HAONMIK1/park-assist/docs/hardware.md

# 하드웨어

## 구성

**독립된 유닛 두 대**를 앞뒤 범퍼에 각각 물린다
([ADR 0004](decisions/0004-two-device-split.md)).

| 유닛 | 광고 이름 | 장착 위치 | 센서 |
| --- | --- | --- | --- |
| 후방 | `PARK-01` | 뒤 번호판 / 트렁크 리드 | 4 |
| 전방 | `PARK-02` | 앞 번호판 | 4 |

두 유닛은 **회로도 핀맵 펌웨어가 완전히 같다.** 펌웨어의 `ZONE_IS_REAR` 매크로만 바꿔서
굽는다. 한쪽이 꺼져도 다른 쪽은 그대로 동작한다.

## 부품 목록 (2대 기준)

| 구분 | 부품 | 수량 | 비고 |
| --- | --- | --- | --- |
| MCU | ESP32 DevKitC 30핀 | 2 | 유닛당 1 |
| 거리 센서 | JSN-SR04T 방수 초음파 모듈 | 8 | 유닛당 4 |
| 경보 | 액티브 부저 HW-508 | 2 | 유닛당 1, 자체 발진 |
| 전원 | (미정) | 2 | 아래 "전원" 참조 |
| 기구 | 집게형 마운트 | 2 | 번호판에 물림 |

## 핀맵 (유닛 공통)

| 채널 | Trig (출력) | Echo (입력) |
| --- | --- | --- |
| CH1 | GPIO 13 | GPIO 34 |
| CH2 | GPIO 25 | GPIO 35 |
| CH3 | GPIO 26 | GPIO 36 (VP) |
| CH4 | GPIO 27 | GPIO 39 (VN) |
| 부저 | GPIO 4 | — |

물리 배치는 **차량을 위에서 봤을 때 CH1이 왼쪽 끝, CH4가 오른쪽 끝**이다.
앞뒤 유닛 모두 운전자 기준 좌우를 따른다. BLE 패킷의 `d1`~`d4`가 이 순서에 대응한다
([`ble-protocol.md`](ble-protocol.md) 참조).

### GPIO 34/35/36/39 주의

- **입력 전용 핀이다.** 출력으로 설정할 수 없다.
- **내부 풀업/풀다운이 없다.** `INPUT_PULLUP`을 쓸 수 없으므로, 플로팅이 문제가 되면
  외부 저항을 단다.
- 36(VP)/39(VN)은 ADC1과 공유된다. 이 프로젝트에서는 디지털 입력으로만 쓴다.

### GPIO 4 (부저)

부저는 **ESP32에 직결**한다. BLE·앱과 무관하게 울려야 하는 안전 경로이므로 중간에
어떤 통신 요소도 두지 않는다 ([ADR 0001](decisions/0001-buzzer-direct-drive.md)).

HW-508은 액티브 부저라 `digitalWrite(HIGH/LOW)`로 켜고 끈다. `tone()` / LEDC PWM으로
주파수를 만들 필요가 없다. **음색을 바꿀 수 없으므로 경보 강도는 울림 간격으로만
표현한다** ([`ble-protocol.md`](ble-protocol.md) 6절).

부저 소비 전류가 GPIO 허용치(권장 12mA, 절대 최대 40mA)를 넘으면 NPN 트랜지스터나
MOSFET으로 구동하고, 코일성 부하일 경우 역기전력 다이오드를 단다.

## JSN-SR04T 특성과 그 결과

| 항목 | 값 |
| --- | --- |
| 동작 전압 | 5V |
| 측정 범위 | 약 25cm ~ 450cm |
| **사각지대(blind zone)** | **약 25cm 이내** |
| 빔 각도 | 약 45~75° (넓음) |

### ⚠️ 사각지대와 "위험" 기준의 충돌

기본 위험 기준은 **30cm**인데 센서 사각지대가 **약 25cm**다. 25cm보다 가까워지면
측정이 실패해 `0xFF`가 올라오고, 이는 프로토콜상 "측정 실패"와 구분되지 않는다.

**가장 위험한 순간에 값이 사라진다**는 뜻이므로, 펌웨어와 앱 양쪽에서 이렇게 처리한다.

- 직전까지 거리가 가까웠는데 `0xFF`로 바뀌면, 멀어진 것이 아니라 **사각지대에 진입한
  것으로 간주**하고 2초간 최고 단계 경보를 유지한다.
- 앱은 이때 숫자 대신 **"매우 가까움"** 을 크게 띄운다. 화면이 비면 안 된다.
- 멀리서 측정이 안 되는 경우(미연결 센서 등)와는 구분한다.

JSN-SR04T V3.0 등 일부 버전은 저항 값을 바꾸거나 모드를 바꾸면 최소 거리가 개선된다.
사용하는 보드 리비전을 확인할 것.

### ⚠️ 주행 중 감지 한계

주행 모드의 급접근 경보([ADR 0003](decisions/0003-app-alarm-and-drive-mode.md))는
이 센서의 물리적 한계에 묶여 있다. 측정 한계 약 250cm, 갱신 10Hz다.

| 상대속도 | 250cm 통과 시간 | 프레임 수 |
| --- | --- | --- |
| 10 km/h (2.8 m/s) | 0.90초 | 약 9 |
| 30 km/h (8.3 m/s) | 0.30초 | 약 3 |
| 60 km/h (16.7 m/s) | 0.15초 | 약 1~2 |

**정체 구간·주차장·저속 시내 주행에서 쓸모가 있고, 고속 추돌 경보로는 쓸 수 없다.**
고속에서 쓰려면 레이더처럼 감지 거리가 훨씬 긴 센서가 필요하다.

### ⚠️ Echo 핀 전압 레벨

JSN-SR04T는 5V로 동작하며 Echo 출력이 **5V 로직**인 보드 리비전이 있다. ESP32 GPIO는
3.3V까지만 허용하므로, 실측 후 필요하면 분압 저항(예: 10kΩ / 20kΩ)이나 레벨 시프터를
넣는다. **조립 전 오실로스코프나 멀티미터로 Echo 진폭을 확인할 것.**

Trig(3.3V 출력 → 5V 입력)는 대개 그대로 인식되지만, 동작이 불안정하면 이쪽도 확인한다.

### 상호간섭

빔 각도가 넓어 4개를 동시에 쏘면 서로의 반사파를 주워 값이 오염된다.
그래서 **순차 발사**가 강제된다 ([ADR 0002](decisions/0002-sequential-sensor-firing.md)).

앞뒤 유닛은 4m쯤 떨어져 있고 서로 반대 방향을 보므로 간섭하지 않는다. 유닛 간 발사
동기화는 필요 없다.

## 타이밍 예산 (유닛당)

전체 갱신 주기 100ms(10Hz)를 4채널이 나눠 쓴다.

| 항목 | 값 |
| --- | --- |
| 채널당 슬롯 | 25ms |
| Trig 펄스 | 10µs |
| 에코 타임아웃 | 20ms (≈ 340cm) |
| 슬롯 여유 | 약 5ms (잔향 감쇠) |

음속 34,300cm/s 기준 왕복이므로 `거리(cm) = 에코시간(µs) / 58`.
타임아웃 20ms는 편도 약 343cm에 해당한다. 프로토콜상 유효 최대값이 254cm이므로
측정 범위로는 충분하다.

> 유닛을 나눈 덕분에 각 유닛이 4채널만 담당해 10Hz가 유지된다. 한 보드에 8개를 물렸다면
> 순차 발사 때문에 5Hz로 떨어졌을 것이다.

## 전원

**미정.** 결정해서 여기에 채울 것. 유닛이 둘이므로 **두 벌** 필요하다.

- 후보 A: 차량 12V → 5V 벅 컨버터. 상시 급전이지만 배선이 차량 내부로 들어간다.
  앞뒤 각각 급전점을 찾아야 한다.
- 후보 B: 18650 리튬 배터리 + TP4056 충전 모듈. 집게형 컨셉에 맞지만 충전을 두 번
  해야 하고 잔량 관리가 필요하다.

앱은 표준 Battery Service(`0x180F`)로 잔량을 읽고, **두 유닛 중 낮은 쪽**을 표시한다.
기기가 이 서비스를 제공하지 않으면 "알 수 없음(`--`)"으로 두고 나머지는 정상 동작한다.

## 조립 시 확인 목록

유닛마다 각각 확인한다.

- [ ] Echo 출력 전압 실측 (5V면 분압 필수)
- [ ] 부저 소비 전류 실측 (GPIO 직결 가능 여부)
- [ ] 채널 좌우 순서가 `d1`=왼쪽 끝인지 실측 확인 (앞뒤 각각)
- [ ] 4채널 순차 발사 시 상호간섭 없는지 확인 (한 개씩 가리며 테스트)
- [ ] 25cm 이내 접근 시 `0xFF` 전환 지점 실측
- [ ] 광고 이름이 `PARK-01` / `PARK-02`로 서로 다른지 확인 (같으면 앱이 두 연결로 같은
      기기를 잡는다)
- [ ] 두 유닛 동시 연결 상태에서 10Hz가 유지되는지 확인
- [ ] 방수/방진 처리 (차량 외부 장착)
