HAONMIK1/park-assist/docs/decisions/0003-app-alarm-and-drive-mode.md

# 0003. 앱 경고음과 주행 모드

- 상태: 채택됨
- 날짜: 2026-08-12

## 맥락

[ADR 0001](0001-buzzer-direct-drive.md)에서 경보는 기기 부저로만 내기로 했고, 앱 소리는
BLE 지연 때문에 어긋나 들린다는 이유로 넣지 않았다.

그 뒤 두 가지 요구가 추가됐다.

1. **경고음이 거리에 따라 연속적으로 세져야 한다.** 단계가 3개뿐이면 기준선을 넘는
   순간에만 소리가 바뀌어서, 그 사이에서 얼마나 가까워지고 있는지 알 수 없다.
2. **주차뿐 아니라 주행 중에도 켜 두고 쓴다.** 티맵을 보며 운전하는 중에 차가 갑자기
   가까이 오면 크게 알려야 한다.

2번이 문제를 만든다. 주차용 규칙(120cm부터 울림)을 주행에 그대로 쓰면 **정체 구간에서
쉬지 않고 울린다.** 앞뒤 차가 1~2m에 있는 건 주행 중 정상 상태다. 반대로 주행용으로
기준을 좁히면 주차할 때 벽을 놓친다.

## 결정

### 1. 경보 강도를 연속 곡선으로 만든다

거리 기준 3개는 경계선일 뿐이고, 그 사이도 선형 보간해 강도 0~1을 만든다.
`far`→0, `mid`→0.34, `near`→0.67, 0cm→1.0.

강도 → 소리 매핑:

| | 울림 간격 | 음량 | 음높이 |
| --- | --- | --- | --- |
| 기기 부저 | 1000ms → 80ms (등비) | 고정 | 고정 |
| 앱 | 1000ms → 80ms (등비) | 35% → 100% | ×1.0 → ×1.45 |

액티브 부저(HW-508)는 음색을 못 바꾸므로 표현 수단이 간격 하나뿐이다. 그래서 앱이
음량·음높이를 더 얹는다. 곡선 자체는 양쪽이 **같은 모양**이어야 하며, 한쪽을 바꾸면
다른 쪽도 같은 PR에서 고친다.

### 2. 주차 / 주행 모드를 나눈다

| | 주차 | 주행 |
| --- | --- | --- |
| 경보 기준 | **거리** | **접근 속도** |
| 앱 소리 | 위 연속 곡선 | 급접근일 때만, 처음부터 최대 강도 |
| 기기 기준값 기본 | 30 / 60 / 120 | 20 / 35 / 50 |

주행 모드는 최근 0.6초의 접근 속도를 계산해 **60cm/s 이상으로 좁혀 올 때만** 울린다
(150cm 이내에서만 따지고, 40cm 이내는 속도와 무관하게 즉시 경보). 한 번 걸리면 2.5초
유지해서 경계선에서 소리가 떨리는 걸 막는다.

기기 부저용 기준값도 모드별로 따로 저장하고, 모드를 바꾸면 앱이 즉시 두 유닛에 밀어
넣는다. 주행용이 좁아서 기기 부저는 평소 조용하고, 정말 닿기 직전에만 반응한다.

전방·후방 **양쪽 다** 감시한다. 앞차와의 급접근(추돌 위험)과 뒤차의 급접근(추돌당할
위험)이 둘 다 의미가 있다. 동시에 걸리면 전방을 먼저 알린다 — 운전자가 대응할 수 있는
쪽이다.

### 3. 앱 소리는 여전히 보조다

기기 부저는 앱 설정과 무관하게 항상 울린다. 설정의 "앱 경고음" 토글은 앱 소리만 끈다.
ADR 0001은 그대로 유효하다.

주행 중 급접근 경보만 오디오 포커스를 `TRANSIENT_MAY_DUCK`으로 잠깐 가져가고
`USAGE_ALARM`으로 낸다. 티맵 안내 음성 위로 들려야 하기 때문이다. 상대 앱을 멈추지 않고
잠깐 줄이기만 한다. 주차 모드에서는 포커스를 건드리지 않는다.

## 결과

- 앱이 처음으로 소리를 내게 됐다. 소리 경로가 두 개(기기·앱)라 미세하게 어긋나 들릴 수
  있다. 감수한다 — 주행 모드에서는 기기 부저가 거의 울리지 않으므로 겹치는 구간이 좁다.
- 모드 전환이 잦은 조작이 되므로 설정이 아니라 **메인 화면 최상단**에 크게 둔다.
- 경보 강도 곡선이 펌웨어와 앱 두 곳에 중복 구현된다. 다르게 갈라지면 소리가 어긋난다.
  문서(`docs/ble-protocol.md` 6절)를 기준으로 삼고 앱 쪽은 단위 테스트로 고정한다.
- **주행 모드의 감지 능력에는 물리적 한계가 있다.** JSN-SR04T는 약 250cm까지만 읽고
  갱신이 10Hz다.

  | 상대속도 | 250cm 통과 시간 | 프레임 수 |
  | --- | --- | --- |
  | 10 km/h | 0.90초 | 약 9 |
  | 30 km/h | 0.30초 | 약 3 |
  | 60 km/h | 0.15초 | 약 1~2 |

  즉 **정체 구간·주차장·저속 시내 주행용이고, 고속 추돌 경보로는 쓸 수 없다.**
  고속에서 쓰려면 감지 거리가 훨씬 긴 센서(레이더 등)가 필요하다. 이 한계는 앱 UI와
  코드 주석에 명시한다.

## 검토한 대안

- **주행 중에도 거리 기준만 사용**: 정체 구간에서 계속 울려 사용자가 앱을 꺼 버린다.
  경보를 무시하게 만드는 게 가장 나쁜 결과다.
- **모드 자동 전환(속도 센서/GPS 기반)**: 위치 권한이 필요해진다. 매니페스트에
  `neverForLocation`을 선언해 둔 것과 충돌하고, 60대 사용자에게 권한을 하나 더 요구하게
  된다. 수동 전환으로 충분하다.
- **주행 중 기기를 대기 모드로 두고 앱만 경보**: ADR 0001 위반이다. 안전 기능을 폰에
  의존시키게 된다. 기준값을 좁히는 쪽이 같은 효과를 내면서 원칙을 지킨다.
- **앱 소리를 아예 넣지 않음**: 화면을 보지 않는 주행 중에는 소리 말고 전달 수단이 없다.
