HAONMIK1/park-assist/docs/decisions/0004-two-device-split.md

# 0004. 전방·후방을 기기 두 대로 나눈다

- 상태: 채택됨
- 날짜: 2026-08-12

## 맥락

센서를 후방 4개에서 **전방 4개 + 후방 4개, 총 8개**로 늘리기로 했다.

한 대의 ESP32로 8개를 다 물릴 수도 있다. DevKitC 30핀에 Trig 8 + Echo 8 = 16핀은
들어간다. 하지만 앞뒤 범퍼는 4m쯤 떨어져 있어서, 한 보드로 묶으면 **방수 케이블 4가닥을
차 안으로 관통시켜** 반대편 범퍼까지 끌어야 한다. 집게로 물려 쓰는 제품 컨셉과도 맞지
않는다.

패킷 규격도 문제가 된다. 8채널을 한 패킷에 담으려면 `[0xAA][d1..d8][XOR]` 10바이트로
확장하거나 존 바이트를 추가해야 하는데, 이미 확정된 6바이트 규격을 깨는 일이다.
게다가 한 보드에서 8개를 순차 발사하면(ADR 0002) 갱신 주기가 10Hz에서 5Hz로 반토막 난다.

## 결정

**범퍼마다 독립된 ESP32 유닛을 하나씩 둔다.**

| 유닛 | 광고 이름 | 센서 |
| --- | --- | --- |
| 후방 | `PARK-01` | 4 |
| 전방 | `PARK-02` | 4 |

- 펌웨어는 **한 벌**이고 `ZONE_IS_REAR` 매크로만 바꿔 굽는다.
- 두 유닛은 서비스·캐릭터리스틱 UUID가 완전히 같고 **광고 이름만 다르다.**
- 앱이 두 기기에 **동시에** BLE 연결을 유지하고, 각 연결을 독립적으로 재시도한다.
- 앱은 존별로 상태를 들고 있고(`SensorZone`), 명령(`0xBB`/`0xCC`)은 두 유닛에 각각 보낸다.

패킷 규격은 4채널 6바이트 그대로 둔다. **어느 연결로 왔는지가 곧 방향**이므로 패킷에
방향 정보를 넣을 필요가 없다.

## 결과

- 확정된 패킷 규격을 건드리지 않았다. 기존 후방 펌웨어가 그대로 산다.
- 각 유닛이 4채널 순차 발사를 유지하므로 **갱신 주기 10Hz가 그대로다.**
- 유닛 하나가 꺼지거나 배터리가 나가도 다른 쪽은 그대로 동작한다. 앱은 존별 연결
  상태를 따로 표시한다.
- 부저가 두 개가 된다. 앞뒤에서 각각 울리므로 방향을 소리로도 구분할 수 있다.
- 전원·충전·펌웨어 업데이트를 두 번 해야 한다. 배터리 표시는 **둘 중 낮은 쪽**을 쓴다.
- **두 유닛이 같은 서비스 UUID를 광고하므로, 스캔에서 서비스 UUID만 보면 두 연결이 같은
  기기를 잡는다.** 앱은 연결 전에 광고 이름을 반드시 확인한다
  (`DeviceConnection.matchesZone`). 펌웨어는 광고 패킷에 이름을 반드시 실어야 한다.
- 앱의 BLE 계층이 존 단위로 추상화됐다(`BleRepository.zones`). 나중에 "1대 + 8센서"로
  방향을 틀더라도 그 아래 구현만 갈아 끼우면 화면·경보 코드는 그대로 쓸 수 있다.

## 검토한 대안

- **1대 + 8센서, `[0xAA][d1..d8][XOR]` 10바이트**: 확정 규격 변경 + 차량 관통 배선 +
  갱신 주기 반토막. 세 가지 비용을 모두 치른다.
- **1대 + 8센서, `[0xAA][zone][d1..d4][XOR]` 7바이트 번갈아 전송**: 패킷은 짧게 유지되지만
  배선과 갱신 주기 문제는 그대로다.
- **후방만 유지**: 요구사항(주행 중 전방 급접근 경보)을 만족할 수 없다.
