HAONMIK1/park-assist/docs/decisions/0001-buzzer-direct-drive.md

# 0001. 부저는 ESP32 직결, BLE와 독립

- 상태: 채택됨
- 날짜: 2026-08-10

## 맥락

이 장치는 주차 중 후방 충돌을 막는 것이 목적이다. 경보를 어디서 울릴지에는 두 가지
선택지가 있었다. 기기에 붙은 부저로 울리거나, 폰 앱이 소리를 내거나.

앱에서 울리면 볼륨·음색·음성 안내 같은 걸 마음대로 만들 수 있어 매력적이다. 하지만
그 경로에는 BLE 연결, 안드로이드 백그라운드 제한, 배터리 최적화, 앱 크래시, 폰 무음
모드, 블루투스 꺼짐 같은 실패 지점이 줄줄이 끼어 있다. 이 중 하나만 어긋나도
**후진하는 순간에 경보가 안 울린다.**

## 결정

부저(HW-508)는 ESP32 GPIO 4에 직결하고, **경보 판정과 구동을 펌웨어 안에서 완결한다.**

부저를 울리는 코드 경로에 BLE 연결 상태, 앱에서 받은 명령, 폰의 존재 여부가
조건으로 들어가면 안 된다. 폰이 한 번도 연결된 적 없어도, BLE 스택이 죽어도, 센서가
측정되는 한 부저는 울린다.

앱은 **보조 표시 장치**다. 기기가 이미 판정한 결과를 보여줄 뿐, 경보 여부를 결정하지
않는다.

예외는 명시적 전원 제어(`0xCC 0x00` 대기 모드) 하나뿐이다. 사용자가 직접 끈 경우이며,
기기의 기본 상태는 항상 **작동**이다. 부팅 시 기본값을 대기로 두지 않는다.

## 결과

- 앱 없이도 제품이 성립한다. 앱은 편의 기능이지 필수 부품이 아니다.
- 경보 단계 판정 로직이 펌웨어에 있어야 한다. 거리 기준(`0xBB`)은 앱이 바꿀 수 있지만,
  그 값으로 판정하는 주체는 기기다.
- 사각지대 진입 처리(`docs/hardware.md` 참조) 같은 안전 판정도 전부 펌웨어 몫이다.
- 액티브 부저라 음색을 못 바꾼다. 경보 단계는 **울림 간격**으로만 표현한다.
- 앱에만 존재하는 경고 기능을 추가하고 싶은 유혹이 생기면, 그건 이 결정을 어기는
  것이다. 필요하면 펌웨어에 먼저 넣는다.

## 검토한 대안

- **앱에서 소리 재생**: 위에 적은 실패 지점 때문에 기각. 안전 기능을 사용자의 폰 설정에
  의존시킬 수 없다.
- **양쪽 다 울림**: 기기 부저를 주 채널로 두는 건 같으므로 나중에 추가할 수 있다.
  다만 앱 소리는 BLE 지연(수십~수백 ms)만큼 늦게 울려 서로 어긋나 들린다. 지금은
  넣지 않는다.
