HAONMIK1/park-assist/(commit log)

2026-08-10 Initialize park-assist monorepo structure
    ESP32 기반 집게형 후방 주차 센서. 펌웨어(Arduino/C++)와
    안드로이드 앱(Kotlin/Compose)을 한 저장소에서 관리한다.
    - CLAUDE.md: 프로젝트 개요, 핀맵, 개발 원칙 4가지, 빌드 명령
    - docs/ble-protocol.md: BLE 패킷 규격 단일 진실 공급원
    - docs/hardware.md: 부품, 배선 주의사항, 타이밍 예산
    - docs/decisions/: ADR 0001(부저 직결), 0002(순차 발사)
    - firmware/park-assist-fw/: 논블로킹 스케줄러 스켈레톤, BLE는 TODO
    - android/ParkAssist/: 설계 확정 전 플레이스홀더
    - .gitignore: Android + Arduino/PlatformIO 겸용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
2026-08-13 안드로이드 앱 추가: 기기 2대 BLE 연결, 주행 모드, 연속 경보음
    전방(PARK-02)·후방(PARK-01) ESP32 두 대에 동시 연결하는 안드로이드 앱을
    구현하고, 그에 맞춰 규격·펌웨어·문서를 갱신했다.
    기기 2대 구성 (ADR 0004)
    - 범퍼마다 독립 유닛. 펌웨어는 한 벌이고 ZONE_IS_REAR 만 바꿔 굽는다
    - 6바이트 패킷 규격은 그대로. 어느 연결로 왔는지가 곧 방향이다
    - 두 유닛이 같은 서비스 UUID를 광고하므로 연결 전 이름 확인이 필수다
    - 유닛당 4채널을 유지해 갱신 주기 10Hz가 그대로다
    경보 강도 연속 곡선 (ADR 0003)
    - far→0, mid→0.34, near→0.67, 0cm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
2026-08-13 펌웨어 BLE 통신과 NVS 설정 저장 구현
    TODO로 남아 있던 BLE 계층과 설정 저장을 채웠다.
    BLE
    - 이름과 서비스 UUID를 광고에 함께 싣는다. 앞뒤 유닛이 같은 UUID를 쓰므로
    이름이 없으면 앱의 두 연결이 같은 기기를 잡는다 (ADR 0004).
    광고 페이로드가 30/31바이트라 여유가 1바이트뿐이니 뭘 더 넣지 말 것.
    스캔 응답에도 이름을 넣어 광고가 잘리는 환경을 대비했다
    - TX notify + BLE2902(CCCD). 이게 없으면 앱이 알림을 켤 방법이 없다
    - RX write 콜백 → 기존 bleHandleCommand() 연결
    - 연결이 끊기면 광고를 다시 켠다. 안 켜면 앱이 영영 재연결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
2026-08-13 CI 추가: 앱 빌드·테스트와 펌웨어 컴파일
    앱과 펌웨어는 BLE 패킷 규격으로만 붙어 있어서 한쪽만 고치면 조용히 어긋난다.
    PR마다 둘 다 빌드한다.
    android 잡
    - testDebugUnitTest — protocol 계층 47개. 여기서 깨지면 docs/ble-protocol.md 와
    코드가 갈라진 것이다
    - assembleDebug — Compose/BLE 코드가 실제로 컴파일되는지
    - lintDebug — 지금은 continue-on-error. 리포트는 아티팩트로 남긴다
    firmware 잡
    - arduino/compile-sketches 로 esp32:esp32:esp32 컴파일
    - 앞뒤 유닛은 ZONE_IS_REAR 매크로만 다르고 문자열 상수 하나만 바뀌므로
    저장된 값(후방=1)으로 한 번만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
2026-08-13 GattOp 후행 람다가 잘못된 파라미터에 붙던 컴파일 오류 수정
    CI가 잡았다. GattOp(name, exec, result) 순서라 GattOp("이름") { ... } 형태의
    후행 람다가 exec 가 아니라 마지막 파라미터인 result 에 바인딩됐다.
    exec 를 마지막으로 옮겼다. 대부분의 GATT 작업은 결과를 기다리지 않아서
    GattOp("이름") { ... } 로 쓰는 게 자연스럽고, 결과가 필요한 write 만
    GattOp("write RX", deferred) { ... } 로 쓴다. 순서를 되돌리면 같은 문제가
    재발하므로 이유를 주석에 남겼다.
    Claude-Session: https://claude.ai/code/session_01KQwmE8ygmLFwKNb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
2026-08-13 CI 결과 반영: 검증 상태 갱신과 플래시 사용량 경고
    CI가 앱 빌드·테스트와 펌웨어 컴파일을 모두 통과시켰다. 추측으로 적어 뒀던
    "컴파일 안 해봤다" 문구를 사실로 바꾸고, 컴파일 결과에서 나온 수치를 적었다.
    ⚠️ 펌웨어 플래시가 84% 찼다 (1,103,055 / 1,310,720 바이트).
    BLE 스택이 무거워서 기본 파티션 스킴으로는 여유가 203KB뿐이다. Battery Service를
    붙이거나 기능을 더 얹으면 넘칠 수 있어서, 넘쳤을 때 쓸 파티션 스킴(min_spiffs 등)을
    펌웨어 README에 적어 뒀다. 이 프로젝트는 파일시스템을 안 쓰므로(설정은 NVS)
    SPIFFS 영역을 줄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
2026-08-13 화면 레이아웃 수정과 README 화면 소개 추가
    화면을 실제로 렌더링해 보고 나온 두 가지를 고쳤다.
    1. 세로가 짧은 기기에서 레이더가 넘치던 문제
    fillMaxWidth().aspectRatio(1f) 라서 남는 공간과 무관하게 항상 320dp 정사각이
    됐다. 640dp급 화면에서는 아래 요소를 덮는다. CarRadar 가 이미
    min(width, height) 로 반지름을 잡으므로 fillMaxSize 로 바꾸면 항상 원이
    유지되면서 넘치지 않는다.
    2. 링 안쪽 여백이 과했다
    부채꼴이 반지름의 68%까지만 차고 나머지가 비었다. 대상 사용자가 60대라
    크게 보이는 쪽이 낫다. 차량과 밴드를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
